tonminhce/HydroMate/report/images/ac-dc schematic.png

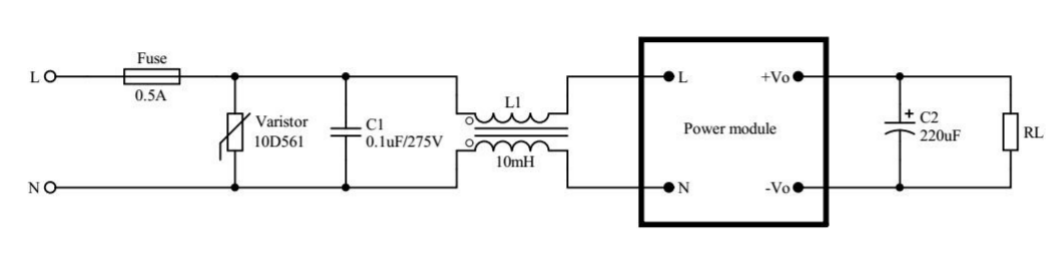
report/images/ac-dc schematic.png
